SnkSynthesis/deadline-dodge/speed-logic/Mod-6_Counter.png

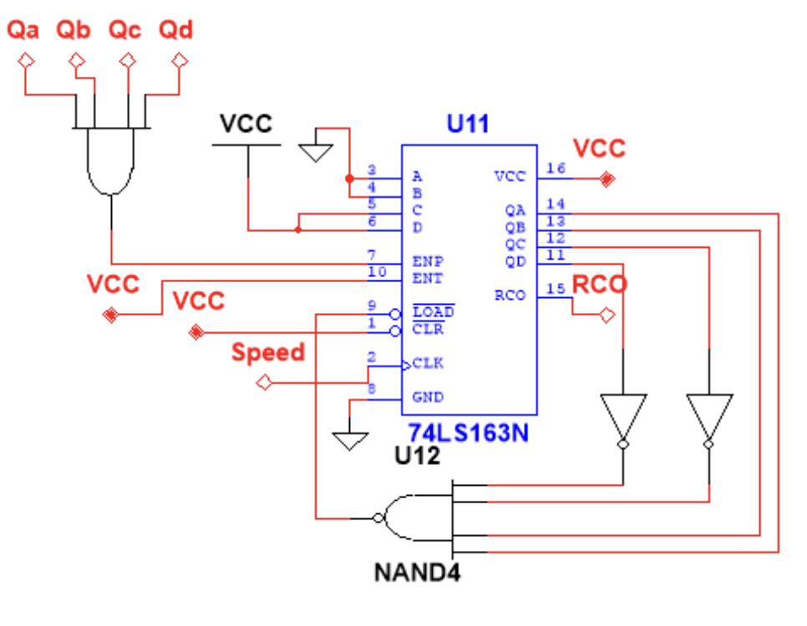
speed-logic/Mod-6_Counter.png
