SnkSynthesis/deadline-dodge/speed-logic/RCO_Speed_Increase_Diagram.png

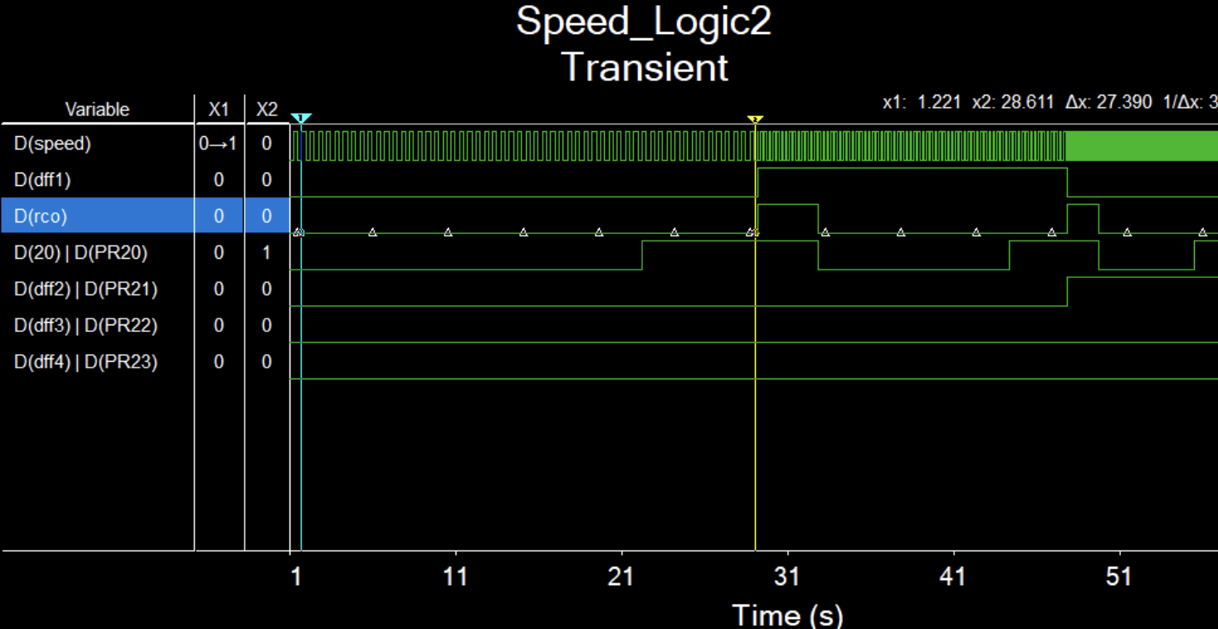
speed-logic/RCO_Speed_Increase_Diagram.png
