SnkSynthesis/deadline-dodge/speed-logic/Timing_For_Jump.png

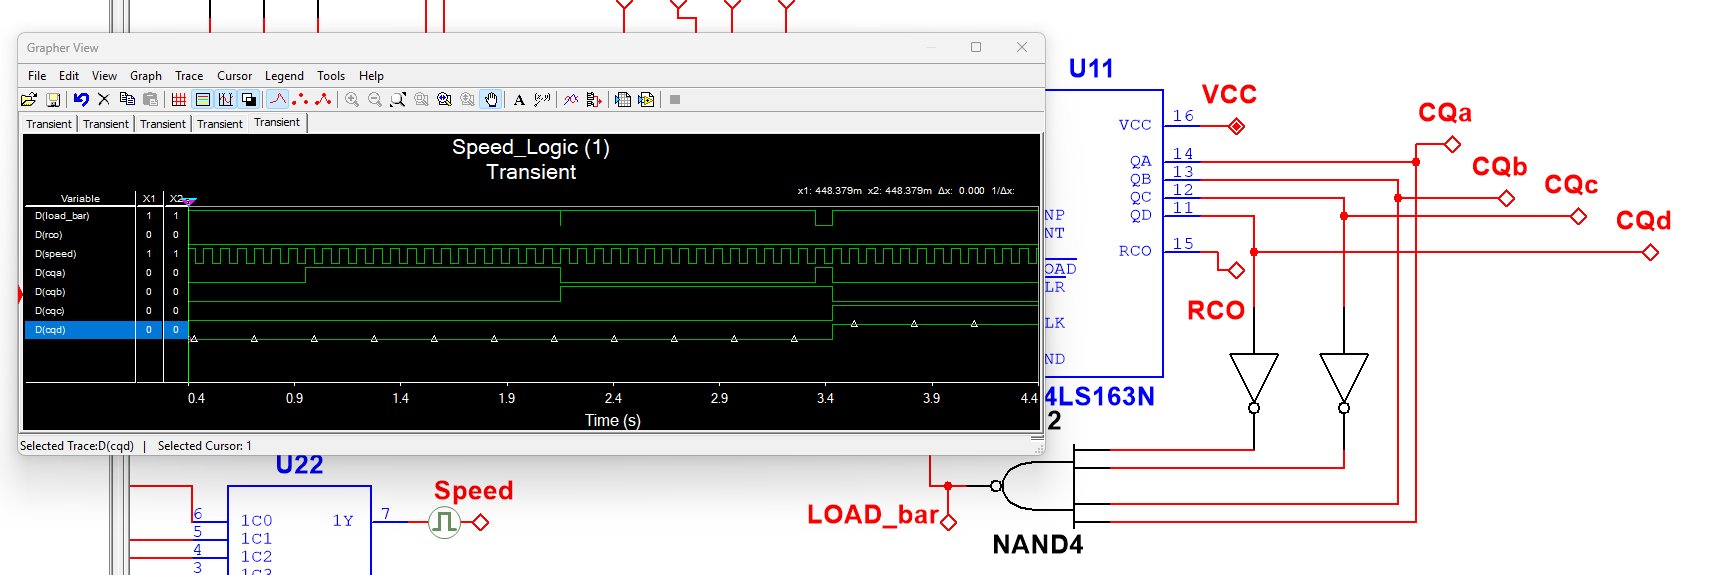
speed-logic/Timing_For_Jump.png
