SnkSynthesis/deadline-dodge/(list of files, drawings)

Other design files:
collision-logic/collision_logic.ms14
lfsr-decoder-logic/LFSR_Decoder_Shiftreg.ms14
player-movement-logic/player_movement_schematic.ms14
speed-logic/Speed_Logic.ms14
