SnkSynthesis/deadline-dodge/(commit log)

2025-06-13 Add overall schematic
2025-06-17 Add .ms14 Multisim files to root of deadline-dodge on branch_c
    [LFSR_Decoder_Shiftreg.ms14, Speed_Logic.ms14]
2025-06-17 Move .ms14 files into proper subfolders and delete originals
    [LFSR_Decoder_Shiftreg.ms14, Speed_Logic.ms14]
2025-06-17 Add Schematic image to speed-logic folder
2025-06-19 Schematic that shows LFSR, 3-8 decoder and an example of column F7 and F5 falling lights
2025-06-19 Update README.md
    trying to merge image of schematic
2025-06-19 Update README.md
    try2 to merge schematic
2025-06-19 Update README.md
    get schematic in readme
2025-08-05 Add player-movement-logic folder (still WIP)
    [player_movement_schematic.ms14]
2025-08-06 Update overall schematic
2025-08-08 Add collision-logic folder
    [collision_logic.ms14]
2025-08-13 Add caption for schematic image
2025-08-13 Add note for schematic
2025-08-13 Add link to schematic image
